Paulusbremmer/nixie1093/TAF1317A/BOM_Nixie-with-power-supply-TAF1317A_2026-10-19.csv

ID | Name | Designator | Footprint | Quantity | Manufacturer Part | Manufacturer | Supplier | Supplier Part | Price
1 | 15kΩ | R21,R24 | R1210 | 2 | AC1210FR-0715KL | YAGEO(国巨) | LCSC | C230040 | 0.01
2 | PZ254R-11-08P | H1 | HDR-TH_8P-P2.54-H-M-W10.4 | 1 | PZ254R-11-08P | XFCN | LCSC | C492416 | 0.055
3 | DW254W-11-08-85 | H2 | HDR-TH_8P-P2.54-H-F-W10.3-N | 1 | DW254W-11-08-85 | DEALON(德艺隆) | LCSC | C2935998 | 0.114
4 | MX126R-5.0-GN01-2P-CU-S-A | HV | CONN-TH_2P-P5.00-L10.0-W10.3 | 1 | MX126R-5.0-GN01-2P-Cu-S-A | MAX(迈旭) | LCSC | C5188436 | 0.084
5 | 100nF | C1,C2,C3 | C0402 | 3 | CC0402KRX7R5BB104 | YAGEO(国巨) | LCSC | C541406 | 0.002
6 | WS2812C/W | LED1,LED2 | LED-SMD_4P-L5.0-W5.0-TL_WS2812B-B | 2 | WS2812C/W | worldsemi | LCSC | C2761796 | 0.142
7 | z570M | N2,N1 | Z570M | 2 | Z570M | RFT Electronic | RFT Electronic | Z570M
8 | BF820,215 | Q0,Q1,Q2,Q3,Q4,Q5,Q6,Q7,Q8,Q9,Q10,Q11,Q12,Q13,Q14,Q15,Q16,Q17,Q18,Q19,Q20 | SOT-23-3_L2.9-W1.3-P1.90-LS2.4-BR | 21 | LMBTA42LT1G | LRC(乐山无线电) | LCSC | C78717 | 0.025
9 | 10kΩ | R0,R1,R2,R3,R4,R5,R6,R7,R8,R9,R10,R11,R12,R13,R14,R15,R16,R17,R18,R19,R20 | R0603 | 21 | ARG03FTC1002 | Viking(光颉) | LCSC | C217687 | 0.008
10 | 390kΩ | R23 | R0603 | 1 | 0603WAJ0394T5E | UNI-ROYAL(厚声) | LCSC | C25595 | 0.001
11 | SM74HC595D | U1,U2,U3 | SOP-16_L10.0-W3.9-P1.27-LS6.0-BL | 3 | SM74HC595D | 明微 | LCSC | C93838 | 0.094
12 | NO | NEON | NIXIE-DOT_BIG | 1
