Paulusbremmer/nixie1093/case/in8-2-voet-10mm.stl

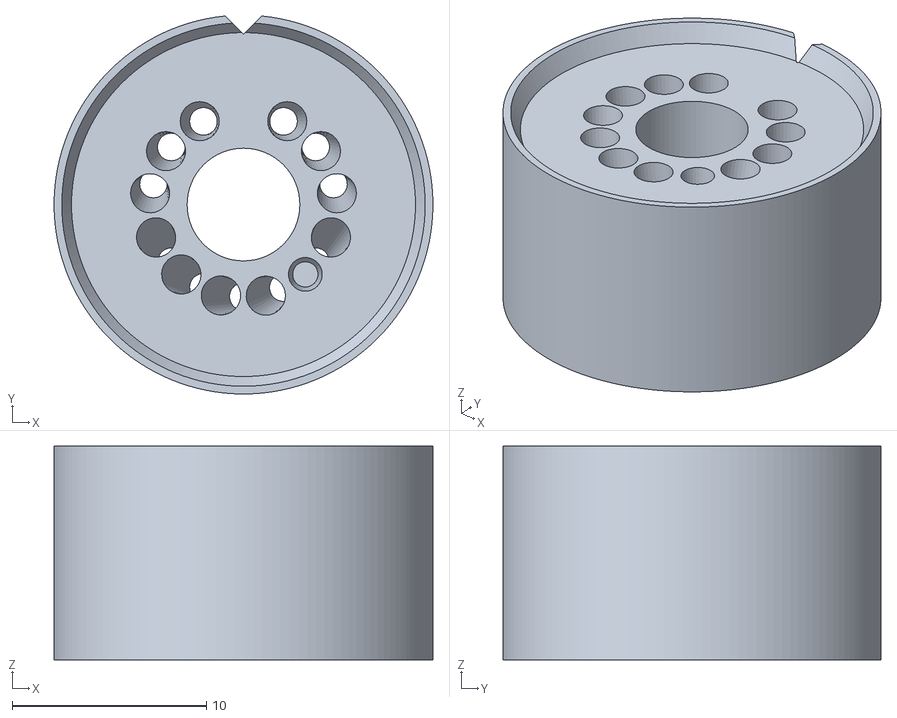
[picture p2: CAD file, 2026-10-23]
case/in8-2-voet-10mm.stl
19.5 x 19.5 x 11.0
