Paulusbremmer/nixie1093/case/in8-2-voet-10mm-set4.stl

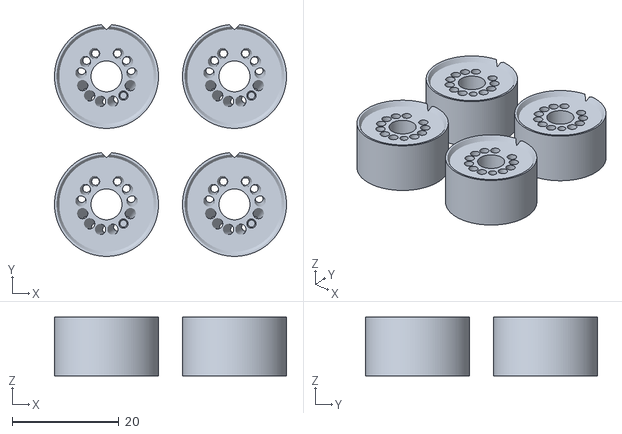
[picture p3: CAD file, 2026-10-23]
case/in8-2-voet-10mm-set4.stl
43.5 x 43.5 x 11.0
