Paulusbremmer/nixie1093/(list of files, drawings)

Other design files:
TAF1317A/PCB_PCB_Nixie-board-for-TAF1317A_2026-10-19.json
