Paulusbremmer/nixie1093/TAF1317A/Gerber_Nixie-with-power-supply-TAF1317A_PCB_Nixie-board-for-TAF1317A_2026-10-19/How-to-order-PCB.txt

How to Order PCB

Please refer to:
https://docs.easyeda.com/en/PCB/Order-PCB
