Paulusbremmer/nixie1093/case/boormal-in8-2-print-A4.html

1:1 Printbare A4 Boormal (IN-8-2 Nixie Klok) — Zet bij het afdrukken (Ctrl+P) de schaal op 100% / Werkelijke grootte en controleer de 100.0 mm maatbalk onderaan met een schuifmaat of liniaal.

🖨️ Afdrukken op Schaal 1:1
