Paulusbremmer/nixie1093/(commit log)

2026-10-21 Initial commit: Modular ESPHome Nixie Clock (TAF1093 / TAF1317A / Z570M / IN-8-2)
    [BOM_Nixie-with-power-supply-TAF1317A_2026-10-19.csv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]
2026-10-21 Add ready-to-order Gerber ZIP archive
2026-10-21 Add ESP32-C3 Mini / SuperMini configuration (nixie1093-c3.yaml)
2026-10-21 Update nixie1093-c3.yaml for ESP32-C3 SuperMini single-row pinout (5.5V, GND, 4, 3, 2, 1, 0)
2026-10-21 Use unique device name nixie1093-c3 in nixie1093-c3.yaml
2026-10-21 Add 3mm laser-cut seamless inset case and 3 engraving options for IN-8-2 clock
2026-10-21 Update laser-cut IN-8-2 case to rounded-corner blind inside kerf-bend with 3 subtle Steampunk engraving themes
2026-10-22 Switch IN-8-2 enclosure to low-profile no-bend stacked rounded-corner design with rear electronics bay and Steampunk inlays
2026-10-23 Add 1:1 IN-8-2 drilling template (SVG & A4 printable HTML) with center points and exact tube pitches for solid wood enclosure
2026-10-23 Add clean direct-on-wood laser marking SVG with only 4x 20mm tube circles and center points
2026-10-23 Add 3D-printable 10mm IN-8-2 to TAF1317A adapter foot with slanted pin guide channels (STL & OpenSCAD)
    [in8-2-voet-10mm-set4.stl, in8-2-voet-10mm.scad, in8-2-voet-10mm.stl]
2026-10-23 Update IN-8-2 10mm foot STL: solid base, full 12-pin through channels to PCB NC hole
    [in8-2-voet-10mm-set4.stl, in8-2-voet-10mm.scad, in8-2-voet-10mm.stl]
2026-10-23 Optimize IN-8-2 10mm foot STL: clip pin 8, clean straight slanted channels, thick inner walls
    [in8-2-voet-10mm-set4.stl, in8-2-voet-10mm.scad, in8-2-voet-10mm.stl]
2026-10-23 Fix STL mesh: guarantee 100% open through-holes on top and bottom faces
    [in8-2-voet-10mm-set4.stl, in8-2-voet-10mm.stl]
2026-10-23 Generate 100% CAD-exact watertight manifold STL using Manifold3D CSG boolean engine
    [in8-2-voet-10mm-set4.stl, in8-2-voet-10mm.stl]
2026-10-23 Add blind pocket for Pin 8 on top surface (6.5mm depth), sealed at bottom
    [in8-2-voet-10mm-set4.stl, in8-2-voet-10mm.stl]
2026-10-23 Reduce Pin 8 blind pocket depth to 2.5mm to maintain thick solid wall to Pin 9
    [in8-2-voet-10mm-set4.stl, in8-2-voet-10mm.stl]
2026-10-25 Update ESP32-C3 pinout: LED=GPIO2, EN=GPIO3, CLK=GPIO4, DI=GPIO5
2026-10-25 Update DI pin from GPIO5 to GPIO1 on ESP32-C3
